lnls-sirius/usb-rs232-converter/files/BOM - Conversor USB-RS232.xls

Designator | Description | Value | PartNumber | Package | Manufacturer | Quantity | Obs.
C1 | Multilayer Ceramic Capacitors 4.7µF 50V ±10% X7R 1210 SMD | 4.7µF | GRM32ER71H475KA88L | 1210 | Murata | 1 | N/A
C2,C5 | Multilayer Ceramic Capacitor 100nF 100V 5% SMD 0805 X7R | 100nF | 08051C104JAT2A | 0805 | AVX | 2 | N/A
C3 | Ceramic Capacitor 10nF 50V 5% SMD 0805 C0G | 10nF | GRM2195C1H103JA01D | 0805 | Murata | 1 | N/A
C4,C6,C8 | Multilayer Ceramic Capacitor 330nF 25V 5% SMD 0805 X7R | 330nF | 08053C334JAT2A | 0805 | AVX | 3 | N/A
C7 | Multilayer Ceramic Capacitor 47nF 100V 5% SMD 0805 X7R | 47nF | 08051C473JAT2A | 0805 | AVX | 1 | N/A
FB1 | Ferrite Bead 40 ohm @100MHz SMD 0805 | 40Ω @ 100 MHz | 875-MI0805K400R-10 | 0805 | Laird-Signal Integrity | 1 | N/A
R4,R5 | Resistor 330 ohm, 1/8W, SMD 0805, Thick Film | 330Ω | RC0805FR-07330RL | 0805 | Yageo | 2 | N/A
U1 | USB Bridge IC, USB to UART Interface | FT232RL-REEL | FT232RL-REEL | SSOP-28 | FTDI | 1 | N/A
U2 | Transceiver Full RS232 IC | MAX3243EIDWR | MAX3243EIDWR | SOIC-28 | Texas Instruments | 1 | N/A
fiducial,fiducial | Fiducial_1mm_Dia_2 | Fiducial_1mm_Dia_2 | NA | NA | NA | 2 | N/A
P1 | USB - mini B USB 2.0 OTG Receptacle Connector 5 Position Through Hole, Right Angle, Horizontal | USB Mini-B | 548190519 | USB - mini B | Molex | 1 | Should not be bought nor soldered
D1, D2 | LED Circuit Board Indicator Single Green Diffused, Tinted 2.2V 20mA Round with Domed Top, 3mm (T-1) Through Hole, Right Angle | LED | WP934CB/GD | Straight_1x2 pitch 2.54m | Kingbright | 2 | Should not be bought nor soldered
P2 | 9 Position D-Sub Plug, Male Pins Connector, Through Hole, Right Angle Solder | DB-9 | A118453-ND | D-Sub 9 positions | TE Connectivity | 1 | Should not be bought nor soldered
