lnls-sirius/usb-rs232-converter/kicad/BOM - Conversor USB-RS232.xls

Designator | Description | Value | PartNumber | Package | Manufacturer | Quantity
C1 | Ceramic Capacitor 4.7 | 4.7µF |  | 1210 |  | 1
C2,C5 | Multilayer Ceramic Capacitor 100nF 100V 5% SMD 0805 X7R | 100nF | 08051C104JAT2A | 0805 | AVX | 2
C3 | Ceramic Capacitor 10nF 50V 5% SMD 0805 C0G | 10nF | GRM2195C1H103JA01D | 0805 | Murata | 1
C4,C6,C8 | Multilayer Ceramic Capacitor 330nF 25V 5% SMD 0805 X7R | 330nF | 08053C334JAT2A | 0805 | AVX | 3
C7 | Multilayer Ceramic Capacitor 47nF 100V 5% SMD 0805 X7R | 47nF | 08051C473JAT2A | 0805 | AVX | 1
FB1 | Ferrite Bead 40 ohm @100MHz SMD 0805 | 40Ω @ 100 MHz | 875-MI0805K400R-10 | 0805 | Laird-Signal Integrity | 1
R4,R5 | Resistor 330 ohm, 1/8W, SMD 0805, Thick Film | 330Ω | RC0805FR-07330RL | 0805 | Yageo | 2
U1 | USB Bridge IC, USB to UART Interface | FT232RL-REEL | FT232RL-REEL | SSOP-28 | FTDI | 1
U2 | Transceiver Full RS232 IC | MAX3243EIDWR | MAX3243EIDWR | SOIC-28 | Texas Instruments | 1
fiducial,fiducial | Fiducial_1mm_Dia_2 | Fiducial_1mm_Dia_2 | NA | NA | NA | 2
