lnls-sirius/usb-rs232-converter/panel/libreCAD/rear panel.dxf

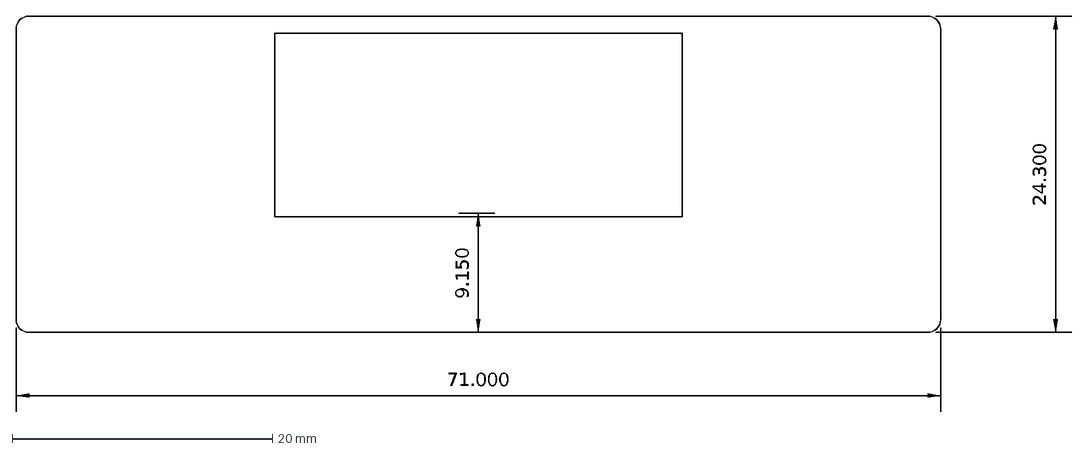
[picture p1: CAD file, 2019-04-09]
panel/libreCAD/rear panel.dxf
71.000
24.300
9.150
