lnls-sirius/usb-rs232-converter/files/Esquemático - Conversor USB-RS232.pdf

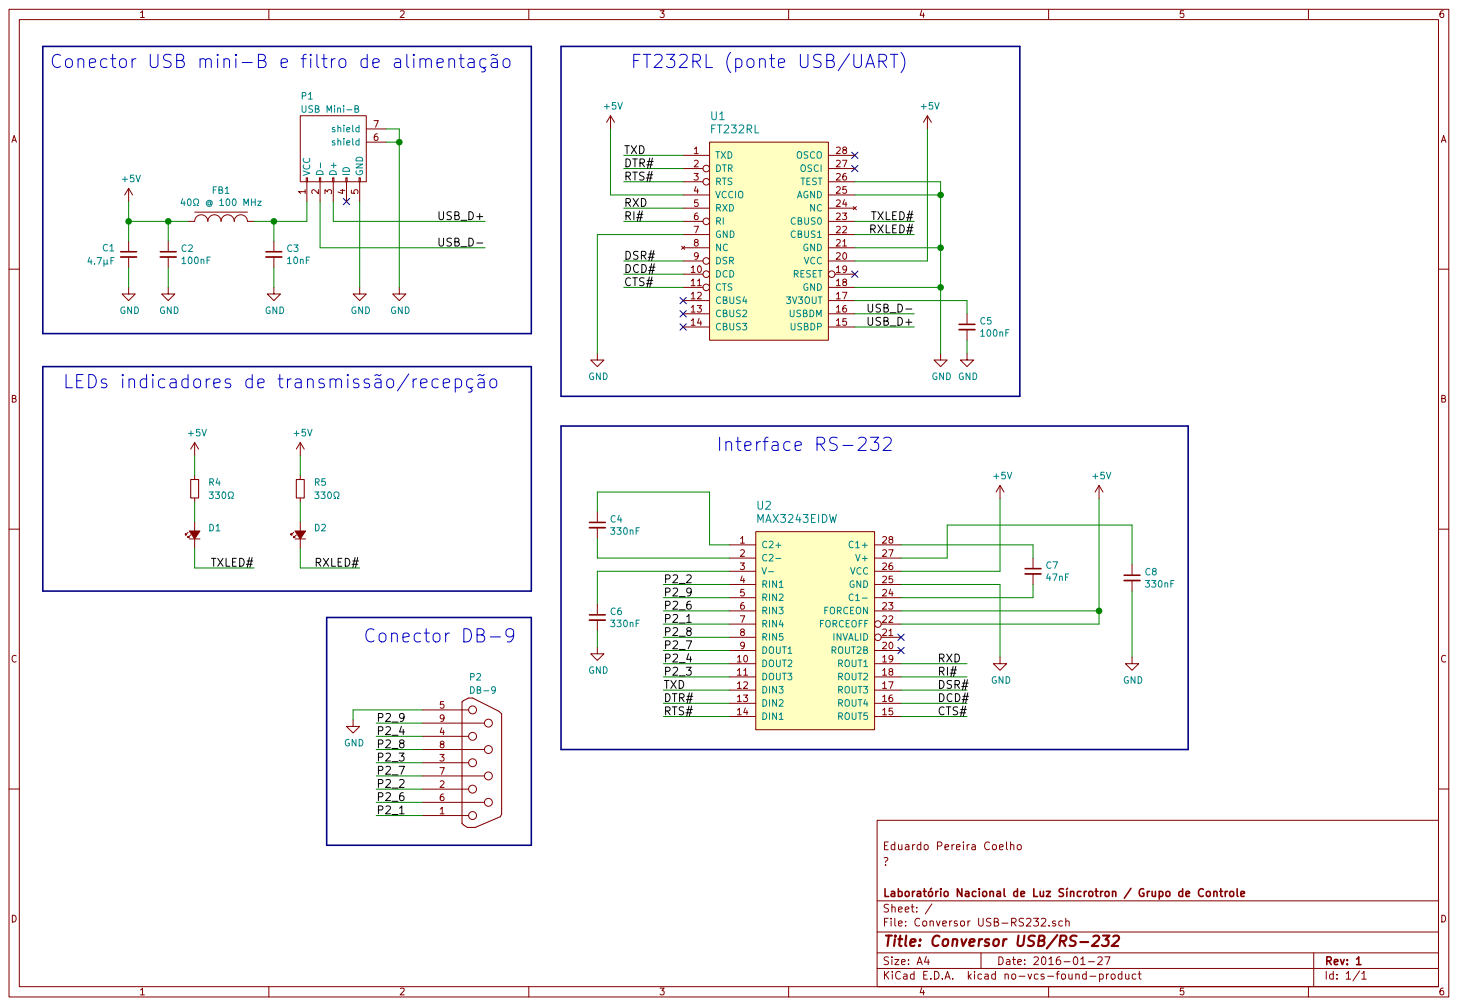
[picture p3: page 1]

Conector USB mini-B e filtro de alimentação

40 @ 100 MHz +5V
RXD LEDs indicadores de transmissão/recepção

File: Conversor USB-RS232.sch Sheet: / Laboratório Nacional de Luz Síncrotron / Grupo de Controle

Id: 1/1 Title: Conversor USB/RS-232
