lnls-sirius/usb-rs232-converter/kicad/Conversor USB-RS232.kicad_pcb

## KiCad design kicad/Conversor USB-RS232.kicad_pcb (2019-04-09)

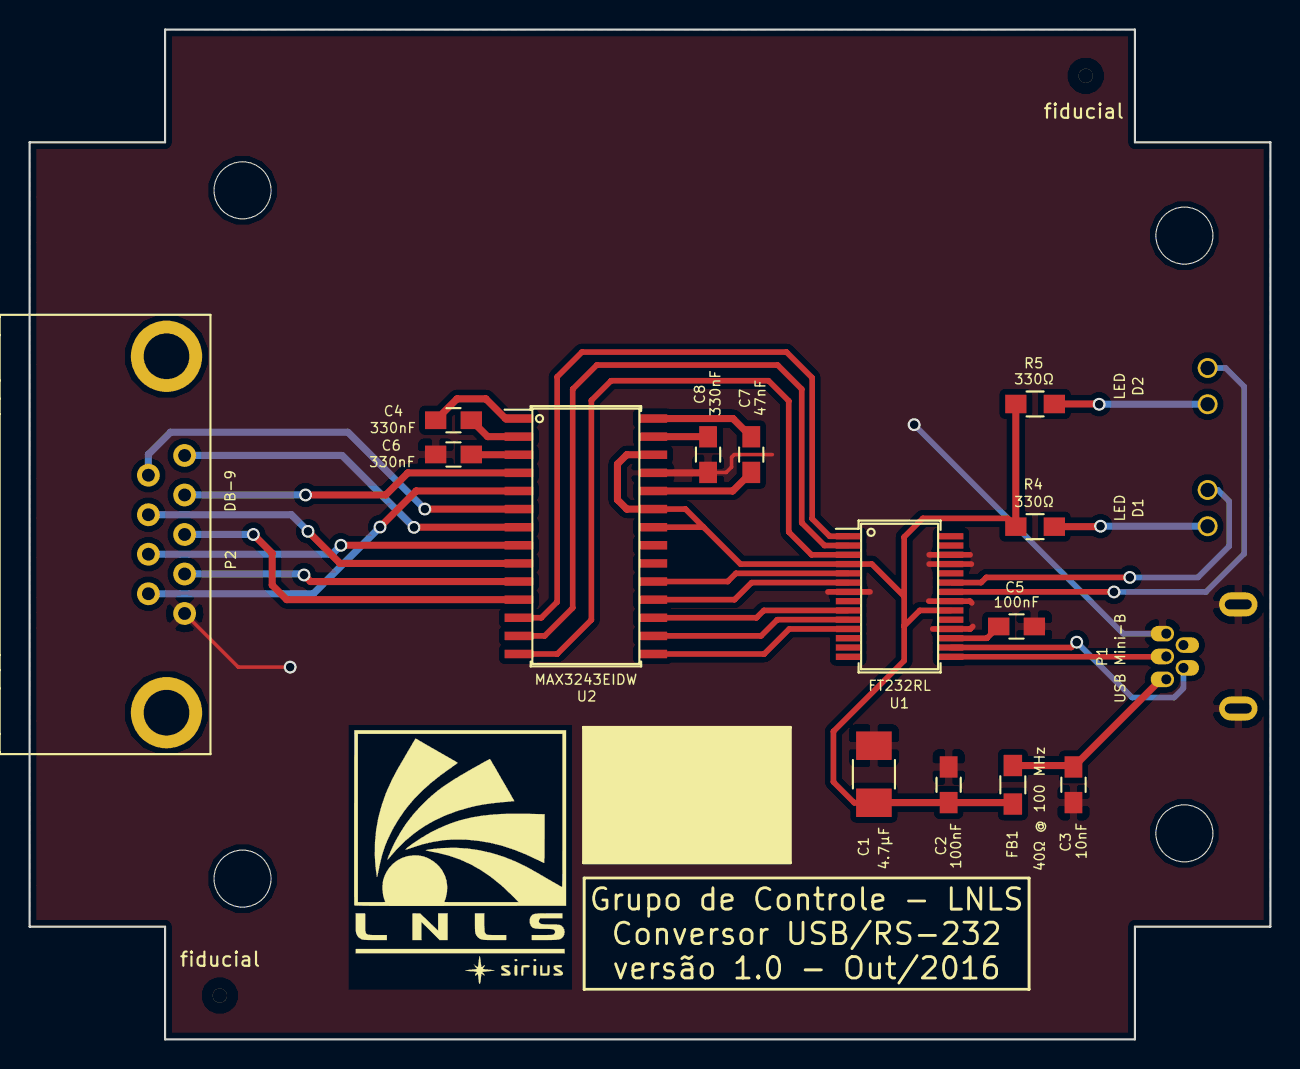
[picture p4: board Conversor USB-RS232.kicad_pcb from above]

Board: 2 copper layers, 87.0 x 70.8 mm, 23 parts (0 on the bottom side), 32 nets.

Parts:
C1: 4.7µF; C_1210_HandSoldering
C2, C5: 100nF; C_0805_HandSoldering
C3: 10nF; C_0805_HandSoldering
C4, C6, C8: 330nF; C_0805_HandSoldering
C7: 47nF; C_0805_HandSoldering
D1, D2: LED; LED_para_painel_KINGBRIGHT
F1, F2, F3, F4: Furo de fixação (4mm); MountingHole_4mm
FB1: 40Ω @ 100 MHz; R_0805_HandSoldering
P1: USB Mini-B; USB_Mini-B
P2: DB-9; DB9_TE
R4, R5: 330Ω; R_0805_HandSoldering
U1: FT232RL; SSOP-28_5.3x10.2mm_Pitch0.65mm
U2: MAX3243EIDW; SOIC-28W_7.5x17.9mm_Pitch1.27mm
fiducial: Fiducial_1mm_Dia_2.54mm_Outer_CopperTop
fiducial#2: Fiducial_1mm_Dia_2.54mm_Outer_CopperTop

Connections:
+5V: C1.1, C2.1, FB1.1, R4.1, R5.1, U1.4, U1.20, U2.22, U2.23, U2.26
/CTS#: U1.11, U2.15
/DCD#: U1.10, U2.16
/DSR#: U1.9, U2.17
/DTR#: U1.2, U2.13
/P2_1: P2.1, U2.7
/P2_2: P2.2, U2.4
/P2_3: P2.3, U2.11
/P2_4: P2.4, U2.10
/P2_6: P2.6, U2.6
/P2_7: P2.7, U2.9
/P2_8: P2.8, U2.8
/P2_9: P2.9, U2.5
/RI#: U1.6, U2.18
/RTS#: U1.3, U2.14
/RXD: U1.5, U2.19
/RXLED#: D2.1, U1.22
/TXD: U1.1, U2.12
/TXLED#: D1.1, U1.23
/USB_D+: P1.3, U1.15
/USB_D-: P1.2, U1.16
GND: C1.2, C2.2, C3.2, C5.2, C6.2, C8.2, P1.5, P1.6, P1.7, P2.5, U1.7, U1.18, U1.21, U1.25, U1.26, U2.25
unnamed: C3.1, FB1.2, P1.1
unnamed: C4.1, U2.1
unnamed: C4.2, U2.2
unnamed: C5.1, U1.17
unnamed: C6.1, U2.3
unnamed: C7.1, U2.28
unnamed: C7.2, U2.24
unnamed: C8.1, U2.27
unnamed: D1.2, R4.2
unnamed: D2.2, R5.2
